lnls-elp/WEG/20150205_BOM_PCB_EXP_RS485.xls

Sheet: BOM_COMP_EXP_RS485
Item | Comment | Description | Designator | Manufacturer | Manufacturer Part Number | Quantity | Unit Price | Final Price | Intern Part Number | Purchased
1 | 10uF | CAP CER 10UF 35V 10% X5R 0805 | C1, C3 | TDK Corporation | C2012X5R1V106K085AC | 2 | 0,7 | 1.4 | AP105062 | OK
2 | 100nF | CAP CER 0.1UF 50V 10% X7R 0603 | C2, C4 | Samsung | CL10B104KB8SFNC | 2 | 0,1 | 0.2 | AP105057 | OK
3 | 133719 | Conector RJ11 SMD, Shielded, EMI Finger | CON1, CON3 | ERNI | 133719 | 2 | 0.77 | 1.54 | AP106016 | OK
4 | DW-04-10-F-S-590 | BOARD SPACING MICRO STRIPS. | CON2 | SAMTEC | DW-04-10-F-S-590 | 1 | 0.143 | 0.143 | AP107722 | OK
5 | FTSH-105-04-L-DV-A | 0.050 INCH DOUBLE VERTICAL SMT TERMINAL STIP. | CON4 | SAMTEC | FTSH-105-04-L-DV-A | 1 | 0.881 | 0.881 | AP107721 | OK
6 | MMBZ6V2ALT1G | TVS DIODE 3VWM 8.7VC SOT23 | D1 | ON Semiconductor | MMBZ6V2ALT1G | 1 | 0,25 | 0.25 | AP105033 | OK
7 | SM712 | Asymmetrical TVS Diode for Extended Common-Mode RS-485 | D2 | SEMTECH | SM712 | 1 | 1,46 | 1.46 | AP100468 | OK
8 | SMAJ11CA | Transient Voltage Suppressor Diode (Bi-Directional) 11V 400W BIDIR 5% SMA | D3 | Littel Fuse | SMAJ11CA | 1 | 0,47 | 0.47 | AP105034 | OK
9 | 220R/100Mhz | FERRITE BEAD,SMD 0805,220 OHMS | L1, L2 | Murata Electronics | BLM21PG221SN1D | 2 | 0,11 | 0.22 | AP105046 | OK
10 | SML-LXR44GC-TR | LED GREEN CLR LENS RA SMD 565NM | LD1 | Lumex Opto/Components Inc | SML-LXR44GC-TR | 1 | 0,58 | 0.58 | AP107062
11 | BC846B,215 | NXP Semiconductors | Q1 | NXP Semiconductors | BC846B | 1 | 0,14 | 0.14 | AP105095 | OK
12 | 499R | RES 499 OHM 1/10W 1% 0603 SMD | R1, R5 | Panasonic | ERJ-3EKF4990V | 2 | 0,1 | 0.2 | AP105081 | OK
13 | 10K | RES 10K OHM 1/16W 5% 0402 SMD | R2, R6 | Yageo | RC0402JR-0710KL | 2 | 0,1 | 0.2 | AP105072 | OK
14 | MMF25SFRE4R75 | RES SMD 4.75 OHM 1% 1/4W MELF | R3, R4 | Yageo | MMF25SFRE4R75 | 2 | 0,28 | 0.56 | AP105089 | OK
15 | HCPL-181-000E | OPTOISO 3.75KV TRANSISTOR 4SOIC | U1 | Avago Technologies US Inc. | HCPL-181-000E | 1 | 0,67 | 0.67 | AP105013 | OK
16 | IL3685E | PROFIBUS RS-485 INTERFACE ISO | U2 | NVE Corp/Isolation Products | IL3685E | 1 | 7,2 | 7.2 | AP102999 | OK
 |  |  |  |  |  | Total Cost ($): |  | 16.114
 |  |  |  |  | Cotação do dolar (R$) | 2.54
 |  |  |  |  |  | Total Cost (R$): |  | 40.92956

Sheet: BOM_MEC_EXP_RS485
Item | Description | Manufacturer | Manufacturer Part Number | Supplier | Quantity | Unit Price | Final Price | Intern Part Number | Purchased
1 | Espaçador sextavado 15mm rosca M3 fêmea/fêmea Bronze | Harwin Inc | R30-1001502 |  | 2 | 1.5 | 3 | AP107696
2 | Espaçador sextavado 7mm rosca M3 macho/fêmea Bronze | Harwin Inc | R30-3000702 |  | 2 | 1.8 | 3.6 | AP107697
3 | Parafuso máquina cabeça panela philips aço niquelado M3X6mm | Aguiafix |  | Aguiafix | 4 | 0.0246 | 0.0984 | AO105170 | OK
 |  |  |  |  | Total Cost (R$): |  | 6.6984
