lnls-elp/WEG/20150205_BOM_PCB_UDC_IHM_V2.0.xls

Item | Comment | Description | Designator | Manufacturer | Manufacturer Part Number | Quantity
1 | 100nF | CAP CER 0.1UF 50V 10% X7R 0603 | C1, C4, C6, C8, C18 | Samsung Electro-Mechanics America, Inc | CL10B104KB8SFNC | 5
2 | 10uF | CAP,CER,SMD 0603,10uF,16V,X5R,+/-20% | C2, C3, C7, C10, C19, C20, C34 | TDK Corporation | C1608X5R1C106M080AB | 7
3 | 10nF | CAP CER 10000PF 16V 10% X7R 0402 | C5, C12, C13, C14, C15, C16, C17 | Samsung | CL05B103KO5NNNC | 7
4 | 100nF | CAP CER 0.1UF 10V 10% X5R 0402 | C9, C11, C21, C22, C23, C24, C25, C26, C27, C32, C33, C35, C36 | Kemet | C0402C104K8PACTU | 13
5 | 22pF | CAP CER 22PF 50V 5% NP0 0402 | C28, C29, C30, C31 | Kemet | C0402C220J5GACTU | 4
6 | CLP-105-02-L-D-A-K-TR | CONN RCPT 10POS DUAL .05" SMD | CON1 | Samtec | CLP-105-02-L-D-A-K-TR | 1
7 | TSM-103-01-S-DV-A-M-TR | Terminal Strip, Dual Row Vertical, Surface Mount, 0.100" Pitch, 6 Pins. | CON2 | SAMTEC | TSM-103-01-S-DV-A-M-TR | 1
8 | MUSB-05-S-B-SM-A-K-TR | USB 2.0, Right Angle, SMT, B Type, Receptacle, 5 Position | CON3 | Samtec | MUSB-05-S-B-SM-A-K-TR | 1
9 | ES2A | Diode | D1 | FAIRCHILD SEMICONDUCTOR | ES2A | 1
10 | MMSD4148 | DIODE SML SIG 100V 0.2A SOD123 | D2 | Fairchild Semiconductor | MMSD4148 | 1
11 | MI0283QT-9A | Display TFT 320x240 com tela resistiva | DISP1 | Multi-inno | MI0283QT-9A | 1
12 | 220R/100Mhz | FERRITE CHIP 220 OHM 0805 | L1, L2, L3 | Murata Electronics | BLM21PG221SN1D | 3
13 | AA3528CGSK | LED GREEN ROUND CLEAR SMD 100mcd, PLLC 2 | LD1 | Kingbright | AA3528CGSK | 1
14 | HSMC-A100-Q00J1 | LED 635NM RED 2-PLCC SMD | LD2 | Avago Technologies US Inc. | HSMC-A100-Q00J1 | 1
15 | LTST-C170KRKT | LED SUPER RED CLEAR 0805 SMD | LD3, LD4 | Lite-On Inc | LTST-C170KRKT | 2
16 | BC846B | TRANS NPN 65V 0.1A SOT23 | Q1, Q2, Q3 | NXP Semiconductors | BC846B,215 | 3
17 | 49.9R | RES 49.9 OHM 1/10W 1% 0402 SMD | R1, R2 | Panasonic Electronic Components | ERJ-2RKF49R9X | 2
18 | 100R | RES 100 OHM 1/8W 1% SMD 0603 | R3, R14 | Vishay Beyschlag | MCT06030C1000FP500 | 2
19 | 100K | RES 100K OHM 1/10W 5% 0603 SMD | R4 | Yageo | RC0603JR-07100KL | 1
20 | 10K | RES 10K OHM 1/16W 5% 0402 SMD | R5, R6, R8, R10, R13, R17, R21, R22 | Yageo | RC0402JR-0710KL | 8
21 | 1K | RES 1.00K OHM 1/8W 1% SMD 0603 | R7 | Vishay Beyschlag | MCT06030C1001FP500 | 1
22 | 12R | RES 12 OHM 1/2W 5% 0805 SMD | R9 | Panasonic Electronic Components | ERJ-P06J120V | 1
23 | 300K | RES 300K OHM 1/10W 1% 0603 SMD | R11, R12 | Panasonic Electronic Components | ERJ-3EKF3003V | 2
24 | 270R | RES 270 OHM 1/10W 1% 0603 SMD | R15, R16 | Vishay Dale | CRCW0603270RFKEA | 2
25 | 499R | RES 499 OHM 1/10W 1% 0603 SMD | R18, R19 | Panasonic | ERJ-3EKF4990V | 2
26 | 33R | RESISTOR, THICK FILM, 33 OHM, 100mW, 1% | R20 | VISHAY DALE | CRCW060333R0FKEA | 1
27 | CSS-73B16K-SMT | BUZZER MAGNETIC 3.6V 8.5MM SMD | SPK1 | CUI Inc | CSS-73B16K-SMT | 1
28 | PTS810 SJM | SWITCH TACTILE SPST-NO 0.05A 16V | SW1 | C&K Components | PTS810 SJM 250 SMTR LFS | 1
29 | NTA7002NT1G | MOSFET N-CH 30V 154MA SOT-416 | T1 | ON Semiconductor | NTA7002NT1G | 1
30 | TPS79533DC | IC REG LDO 3.3V 0.5A SOT223-6 | U1 | Texas Instruments | TPS79533DCQR | 1
31 | USBLC6-2SC6 | STMICROELECTRONICS - USBLC6-2SC6 - ESD PROTECTION, 3.5PF, 17V, SOT23 | U2 | STMICROELECTRONICS | USBLC6-2SC6 | 1
32 | AT24C64D-SSHM-T | IC EEPROM 64KBIT 1MHZ 8SOIC | U3 | Atmel | AT24C64D-SSHM-T | 1
33 | PIC32MX795F512L-80I/PT | High Performance 80 MHz MIPS-Based 32-Bit Flash Microcontroller with USB, CAN and Ethernet, 512KB Program Memory, 100-pin TQFP, V-Temperature, Tape and Reel | U4 | Microchip | PIC32MX795F512L-80I/PT | 1
34 | SN74LVC1G08DBVR | IC GATE AND 1CH 2-INP SOT-23-5 | U5, U7 | Texas Instruments | SN74LVC1G08DBVR | 2
35 | SN74LVC2G06DBVR | IC INVERTER DUAL 1INPUT SOT23-6 | U6 | Texas Instruments | SN74LVC2G06DBVR | 1
36 | SN74LVC1G3157-Q1 | Analog Switch ICs Auto Cat Sngl-Pole Dbl-Thrw Anlg Switch | U8 | Texas Instruments | 1P1G3157QDBVRQ1 | 1
37 | ABS07-32.768KHZ-T | ABRACON - ABS07-32.768KHZ-T - CRYSTAL, 32.768KHZ, 12.5PF, SMD | X1 | ABRACON | ABS07-32.768KHZ-T | 1
38 | ABM3B-8.000MHZ-10-1-U-T | CRYSTAL 8MHZ 10PF SMD | X2 | Abracon Corporation | ABM3B-8.000MHZ-10-1-U-T | 1
