lnls-elp/WEG/20150601_BOM_UDC_PLACA_DE_CONTROLE_V2.0.xlsx

Item | Comment | Description | Designator | Manufacturer | Manufacturer Part Number | Quantity per Board | Intern Part Number | Assembly
1 | BU2032SM-HD-G | HOLDER COIN CELL 2032 SMD | BT1 | MPD (Memory Protection Devices) | BU2032SM-HD-G | 1 | AP107957
2 | 100nF | CAP CER 0.1UF 10V 10% X5R 0402 | C1, C2, C3, C4, C8, C9, C10, C12, C15, C16, C17, C18, C23, C24, C29, C30, C35, C36, C41, C42, C45, C46, C47, C48, C49, C50, C51, C52, C53, C54, C57, C62, C64, C68, C70, C73, C75, C104, C105, C108, C109, C111, C115, C141, C142, C145, C148, C149, C152, C153, C155, C156, C158, C159, C161, C162, C163, C167, C169, C170, C172, C173, C174, C175, C176, C177, C179, C180, C183, C184, C186, C190, C191 | Kemet | C0402C104K8PACTU | 73 | AP105056
3 | 10pF | CAP CER 10PF 50V 5% NP0 0402 | C5, C6 | Samsung Electro-Mechanics America, Inc | CL05C100JB51PNC | 2 | AP107449
4 | 10uF | CAP CER 10UF 16V 20% X5R 0603 | C7, C43, C44, C55, C56, C74, C76, C146, C164, C178, C181, C182, C185,C188, C189 | TDK Corporation | C1608X5R1C106M080AB | 15 | AP105460
5 | 1uF | CAP CER 1UF 16V 10% X7R 0603 | C11, C14, C69, C143, C144, C147, C150, C151, C154, C157, C160, C168, C171, C187, C192 | TDK Corporation | C1608X7R1C105K080AC | 15 | AP105441
6 | 10nF | CAP CER 10000PF 16V 10% X7R 0402 | C13 | Samsung Electro-Mechanics America, Inc | CL05B103KO5NNNC | 1 | AP105053
7 | 100nF | CAP CER 0.1UF 50V 10% X7R 0603 | C19, C20, C21, C22, C25, C26, C27, C28, C31, C32, C33, C34, C37, C38, C39, C40, C65, C66, C72, C112, C114, C122, C123, C128, C129, C166 | Samsung | CL10B104KB8SFNC | 26 | AP105057
8 | 100uF/35V | CAP ALUM 100UF 35V 20% SMD | C58, C59 | Panasonic | EEE-HAV101XAP | 2 | AP105066
9 | 10uF | CAP CER 10UF 35V 10% X5R 0805 | C60, C71, C110, C113, C165 | TDK Corporation | C2012X5R1V106K085AC | 5 | AP105062
10 | 22uF | CAP CER 22UF 16V 20% X5R 1206 | C61 | Murata Electronics | GRM31CR61C226ME15L | 1 | AP105065
11 | 3.3nF | CAP CER 3300PF 25V 10% X7R 0402 | C63 | Kemet | C0402C332K3RACTU | 1 | AP105063
12 | 10nF | CAP CER 10000PF 1.5KV X7R 1812 | C67, C117 | AVX Corporation | 1812SC103KAT1A | 2 | AP107450
13 | 2.2uF | CAP CER 2.2UF 10V 10% X7R 0603 | C77, C78, C79, C88, C89, C90, C91, C92, C93, C94, C95, C96, C97, C98, C99, C100, C101, C102, C103 | Murata Electronics | GRM188R71A225KE15D | 19 | AP105054
14 | 470nF | CAP CER 0.47UF 6.3V 10% X5R 0402 | C80, C81, C82, C83, C84, C85, C86, C87 | Murata Electronics | GRM155R60J474KE19D | 8 | AP105055
15 | 15pF | CAP CER 15PF 50V 5% NP0 0402 | C106, C107 | Murata Electronics | GRM1555C1H150JA01D | 2 | AP105059
16 | 1nF | CAP CER 1000PF 50V 10% X7R 0603 | C116 | Murata | GRM188R71H102KA01D | 1 | AP107451
17 | 1.2nF | CAP CER 1200PF 25V 5% NP0 0603 | C118, C119, C124, C125, C130, C131, C134, C135 | Murata Electronics North America | GRM1885C1E122JA01D | 8 | AP105068
18 | 180nF | CAP CER 0.18UF 25V 10% X7R 0603 | C120, C121, C126, C127, C132, C133, C136, C137 | Murata Electronics North America | GRM188R71E184KA88D | 8 | AP105067
19 | 1uF | CAP CER 1UF 50V 20% X5R 0603 | C138, C139, C140 | TDK Corporation | C1608X5R1H105M080AB | 3 | AP105061
20 | LPJ19201BGNL | Conector RJ45 Ethernet, com trafo, SMD, LINK-PP | CON1 | LINK-PP Int'l Technology Co.,Limited | LPJ19201BGNL | 1 | AP105406
21 | 101-00581-59 | CONN MICRO SD CARD PUSH-PUSH R/A | CON2 | Amphenol Commercial Products | 101-00581-59 | 1 | AP105409
22 | CLP-107-02-L-D-A-K-TR | CONN RCPT 14POS DUAL .05" SMD | CON3 | Samtec | CLP-107-02-L-D-A-K-TR | 1 | AP107723
23 | MUSB-05-S-B-SM-A-K-TR | SAMTEC - MUSB-05-S-B-SM-A-K-TR - CONNECTOR, MINI USB B, RECEPTACLE, SMT | CON4 | Samtec | MUSB-05-S-B-SM-A-K-TR | 1 | AP107443
24 | 374047 |  | CON5 | ERNI | 374047 | 1 | AP102124
25 | 354144 |  | CON6 | ERNI | 354144 | 1 | AP102125
26 | BCS-103-L-D-HE | CONN RCPT 6POS .100" DUAL HORZ | CON7 | Samtec Inc | BCS-103-L-D-HE | 1 | AP107454
27 | CLP-105-02-L-D-A-K-TR | CONN RCPT 10POS DUAL .05" SMD | CON8, CON10 | Samtec | CLP-105-02-L-D-A-K-TR | 2 | AP107441
28 | Header 2 | Header, 2-Pin | CON9, CON11, TP1 |  |  | 3
29 | BAW156 | DIODE ARRAY 85V 140MA SOT23 | D1, D2, D3, D4, D5, D6, D7, D8 | Diodes Incorporated | BAW156-7-F | 8 | AP105032
30 | ES2A | DIODE GEN PURP 50V 2A DO214AA | D9 | FAIRCHILD SEMICONDUCTOR | ES2A | 1 | AP107737
31 | SMAJ16A | TVS DIODE 16VWM SMD | D10 | Littel Fuse | SMAJ16A | 1 | AP105035
32 | BZX84C3V3 | Diode Zener Anode Pin 1 Cathode Pin 3 (Pas de pin 2) | D11, D12 | FAIRCHILD SEMICONDUCTOR | BZX84C3V3 | 2 | AP107738
33 | UPTB10E3/TR13 | TVS DIODE 10VWM 18VC POWRMITE1 | D13, D14, D15, D16, D17, D18, D19, D20 | Microsemi Commercial Components Group | UPTB10E3/TR13 | 8 | AP107455
34 | 220R/100Mhz | FERRITE CHIP 220 OHM 0805 | L1, L5, L6, L7, L8, L9, L10, L23, L24, L26, L27, L28, L29, L30, L31, L32, L33, L34, L35, L36, L37, L38, L39, L40, L41, L42, L43, L48, L49, L50, L51, L52, L53, L54 | Murata Electronics | BLM21PG221SN1D | 34 | AP105046
35 | VLCF4020T-2R2N1R7 | FIXED IND 2.2UH 1.72A 59 MOHM | L2 | TDK Corporation | VLCF4020T-2R2N1R7 | 1 | AP105042
36 | XFL4020-332MEC | Fixed Inductors Power Inductor 3.3 uH 20 % 5.2 A | L3 | Coilcraft | XFL4020-332MEC | 1 | AP105041
37 | 60R/100Mhz | FERRITE CHIP 60 OHM 6000MA 1806 | L4 | Murata Electronics | BLM41PG600SN1L | 1 | AP105045
38 | 60R/100Mhz | FERRITE BEAD 60 OHM 0805 | L11, L12, L13, L14, L15, L16, L17, L18, L19, L20, L21, L22 | Taiyo Yuden | BKP2125HS600-T | 12 | AP105044
39 | DLP11SN900HL2L | CHOKE COIL COMMON MODE 150MA SMD | L25 | Murata Electronics North America | DLP11SN900HL2L | 1 | AP105043
40 | 1000R/100Mhz | FERRITE CHIP 1000 OHM 400MA 0603 | L44, L45, L46, L47 | Murata Electronics | BLM18AG102SN1D | 4 | AP105047
41 | LTST-C170KRKT | LED SUPER RED CLEAR 0805 SMD | LD1, LD2, LD3, LD4, LD5, LD6 | Lite-On Inc | LTST-C170KRKT | 6 | AP105093
42 | MMUN2111LT1G | TRANS PREBIAS PNP 246MW SOT23-3 | Q1 | On Semiconductor | MMUN2111LT1G | 1 | AP105027
43 | MMUN2232LT1G | TRANS PREBIAS NPN 246MW SOT23-3 | Q2 | On Semiconductor | MMUN2232LT1G | 1 | AP105026
44 | NTA7002NT1G | MOSFET N-CH 30V 154MA SOT-416 | Q3, Q4, Q5 | ON Semiconductor | NTA7002NT1G | 3 | AP105437
45 | 49.9R | RES 49.9 OHM 1/10W .1% 0603 SMD | R1, R2, R3, R4, R88, R89, R96, R97, R104, R105, R112, R113, R147, R148, R169, R170, R171, R172, R173, R174, R175, R176 | Panasonic Electronic Components | ERA-3AEB49R9V | 22 | AP105077
46 | 33R | RES 33 OHM 1/16W 5% 0402 SMD | R5, R6, R7, R8, R9, R10, R11, R12, R13, R14, R15, R17, R18, R19, R20, R21, R22 | Yageo | RC0402JR-0733RL | 17 | AP105444
47 | 2.2K | RES SMD 2.2K OHM 5% 1/10W 0603 | R16, R30, R31, R32, R33, R34 | Bourns Inc. | CR0603-JW-222GLF | 6 | AP105446
48 | 2.21K | RES 2.21K OHM 1/10W 1% 0402 SMD | R23, R24, R25, R26, R29, R77, R82, R83 | Panasonic Electronic Components | ERJ-2RKF2211X | 8 | AP105069
49 | 330R | RES 330 OHM 1/16W 5% 0402 SMD | R27, R28, R38 | Yageo | RC0402JR-07330RL | 3 | AP105445
50 | 4.87K | RES 4.87K OHM 1/10W 1% 0603 SMD | R35 | Panasonic Electronic Components | ERJ-3EKF4871V | 1 | AP105447
51 | 10K | RES 10K OHM 1/16W 5% 0402 SMD | R36, R37, R60, R61, R62, R63, R64, R66, R73, R75, R121, R138, R139, R141, R178, R179, R180 | Yageo | RC0402JR-0710KL | 17 | AP105072
52 | 330R | RES 330 OHM 1/10W 5% 0603 SMD | R39, R40, R41, R42, R43, R44, R45, R46, R47, R48, R49, R50, R51, R52, R53, R54 | Panasonic Electronic Components | ERJ-3GEYJ331V | 16 | AP105082
53 | 49.9R | RES 49.9 OHM 1/10W 1% 0402 SMD | R57, R58, R59, R65, R149, R150, R151, R152, R153, R154, R155, R156 | Panasonic Electronic Components | ERJ-2RKF49R9X | 12 | AP105075
54 | 4.99K | RES 4.99K OHM 1/10W 1% 0402 SMD | R67, R84, R85, R157, R158, R159, R160 | Panasonic | ERJ-2RKF4991X | 7 | AP105071
55 | 100K | RES,SMD 0603,100K OHM,5%,1/10 WATT | R68, R94, R95, R102, R103, R110, R111, R118, R119 | Yageo | RC0603JR-07100KL | 9 | AP105076
56 | 10K | RES 10K OHM 1/10W 1% 0603 SMD | R69, R70, R71 | Panasonic Electronic Components | ERJ-3EKF1002V | 3 | AP106688
57 | 2K | RES 2.00K OHM 1/8W 1% SMD 0603 | R72 | Vishay | MCT06030C2001FP500 | 1 | AP105088
58 | 499R | RES 499 OHM 1/10W 1% 0603 SMD | R74, R142, R143, R144, R145, R146, R177 | Panasonic | ERJ-3EKF4990V | 7 | AP105081
59 | 1K | RES 1.00K OHM 1/8W 1% SMD 0603 | R76 | Vishay | MCT06030C1001FP500 | 1 | AP105080
60 | 57.6K | RES SMD 57.6K OHM 1% 1/10W 0402 | R78, R79, R80, R81 | Panasonic Electronic Components | ERJ-2RKF5762X | 4 | AP105070
61 | 24R | RES 24 OHM 1/10W 1% 0603 SMD | R86, R87 | Panasonic Electronic Components | ERJ-3EKF24R0V | 2 | AP107457
62 | 20R | RES SMD 20 OHM 1% 1/10W 0603 | R90, R91, R98, R99, R106, R107, R114, R115 | Panasonic Electronic Components | ERJ-3EKF20R0V | 8 | AP105078
63 | 180R | RES 180 OHM 1/10W 1% 0603 SMD | R92, R93, R100, R101, R108, R109, R116, R117 | Panasonic Electronic Components | ERJ-3EKF1800V | 8 | AP105079
64 | 110R | RES 110 OHM 1/8W 5% 0805 SMD | R122, R123, R124, R125, R126, R127, R128, R129, R130, R131, R132, R133, R134, R135, R136, R137 | Panasonic Electronic Components | ERJ-6GEYJ111V | 16 | AP107458
65 | 680R | RES 680 OHM 1/10W 5% 0603 SMD | R161, R162, R165, R166 | Panasonic Electronic Components | ERJ-3GEYJ681V | 4 | AP107459
66 | 160R | RES 160 OHM 1/2W 5% 0805 SMD | R163, R164, R167, R168 | Panasonic Electronic Components | ERJ-P06J161V | 4 | AP105086
67 | 7914S-1-000E | SWITCH TACTILE SPST-NO 0.1A 24V | SW1 | Bourns | 7914S-1-000E | 1 | AP105040
68 | TLK110PT | Industrial Temp, Single Port 10/100 Mb/s Ethernet Physical Layer Transceiver, -40 to 85 degC, 48-Pin LQFP (PT), Green (RoHS & no Sb/Br) | U1 | Texas Instruments | TLK110PT | 1 | AP105404
69 | F28M36P63C2ZWTT | ARM Microcontrollers - MCU Concerto Microcntrlr | U2 | Texas Instruments | F28M36P63C2ZWTT | 1 | AP105105
70 | TLP2160(F) | ISOLATOR 2.5KVRMS 2CH TOTEM 8SO | U3, U4, U5, U6, U7, U8, U9, U10 | Toshiba Semiconductor and Storage | TLP2160(F) | 8 | AP105011
71 | SN74LVC540APWR | IC INVERTER 8-INPUT 20TSSOP | U11, U12 | Texas Instruments | SN74LVC540APWR | 2 | AP107462
72 | MT48LC32M16A2P-75 IT:C | IC SDRAM 512MBIT 133MHZ 54TSOP | U13 | Alliance Memory, Inc. | MT48LC32M16A2P-75 IT:C | 1 | AP107739
73 | W25Q128FVSIG | IC FLASH 128MBIT 104MHZ 8SOIC | U14 | Winbond Electronics | W25Q128FVSIG | 1 | AP105434
74 | AT24C64D-SSHM-T | IC EEPROM 64KBIT 1MHZ 8SOIC | U15 | Atmel | AT24C64D-SSHM-T | 1 | AP107460
75 | TPS62291DRVT | Buck Step Down Regulator with 2.3 to 6 V Input and 3.3 V Output, -40 to 85 degC, 6-Pin SON (DRV), Green (RoHS & no Sb/Br) | U16 | Texas Instruments | TPS62291DRVT | 1 | AP105005
76 | TPS62143RGTR | Buck Step Down Regulator with 3 to 17 V Input and 5 V Output, -40 to 85 degC, 16-Pin QFN (RGT), Green (RoHS & no Sb/Br) | U17 | Texas Instruments | TPS62143RG | 1 | AP105006
77 | LP3470M5-3.08 | Tiny Power On Reset Circuit, 5-pin SOT-23 | U18 | National Semiconductor | LP3470M5-3.08/NOPB | 1 | AP105019
78 | R-78E5.0-0.5 | CONV DC/DC 5V 500MA OUT THRU | U19 | Recom Power | R-78E5.0-0.5 | 1 | AP105018
79 | RS-0515D/H3 | CONV DC/DC 2W 4.5-9VIN +/-15V | U20 | Recom Power | RS-0515D/H3 | 1 | AP105017
80 | HCPL-181-000E | OPTOISO 3.75KV TRANSISTOR 4SOIC | U21, U51 | Avago Technologies US Inc. | HCPL-181-000E | 2 | AP105013
81 | MCP9701T-E/TT | Low-Power Linear Active Thermistor IC, 3-Pin SOT-23, Extended Temperature, Tape and Reel | U22 | Microchip Technology | MCP9701T-E/TT | 1 | AR101905
82 | ADUM1100ARZ-RL7 | DGTL ISO 2.5KV GEN PURP 8SOIC | U23 | Analog Devices | ADUM1100ARZ | 1 | AP107461
83 | ADUM4160BRWZ-RL | DGTL ISOLATOR 5KV 2CH USB 16SOIC | U24 | Analog Devices Inc | ADUM4160BRWZ-RL | 1 | AP107061
84 | USBLC6-2SC6 | TVS DIODE 5.25VWM 17VC SOT23-6 | U25 | STMicroelectronics | USBLC6-2SC6 | 1 | AP100435
85 | OPA4140AID | 11 MHz, Single Supply, Low Noise, Precision, Rail-to-Rail Output, JFET Amplifier, 4.5 to 36 V, -40 to 125 degC, 14-pin SOIC (D14), Green (RoHS & no Sb/Br) | U26, U27 | Texas Instruments | OPA4140AID | 2 | AP105014
86 | ADS8638SRGER | IC ADC 12B SPI 1MSPS 8CH 24VQFN | U28 | Texas Instruments | ADS8638SRGER | 1 | AP105015
87 | TXB0108PWR | IC 8-BIT TRNSTR 15KV ESD 20TSSOP | U29, U31, U34, U44 | Texas Instruments | TXB0108PWR | 4 | AP104567
88 | PCA9538BS,118 | IC I/O EXPANDER I2C 8B 16HVQFN | U30 | NXP Semiconductors | PCA9538BS,118 | 1 | AP105022
89 | SN74LVC1G08DBVR | IC GATE AND 1CH 2-INP SOT-23-5 | U32, U33, U35 | Texas Instruments | SN74LVC1G08DBVR | 3 | AP104997
90 | IDT74FCT162244ET | IC BUFF DVR 16BIT N-INV 48TSSOP | U36 | IDT, Integrated Device Technology Inc | IDT74FCT162244ETPAG | 1 | AP105010
91 | TPS2051BDBVR | IC PWR DIST SWITCH SNGL SOT23-5 | U37 | Texas Instruments | TPS2051BDBVR | 1 | AP105524
92 | SN74LVC2G06DBVR | IC INVERTER DUAL 1INPUT SOT23-6 | U38, U43, U46 | Texas Instruments | SN74LVC2G06DBVR | 3 | AP107447
93 | Si8662BC-B-IS1R | DGTL ISO 3.75KV GEN PURP 16SOIC | U39 | Silicon Labs | SI8662BC-B-IS1 | 1 | AP105458
94 | ISO1540DR | IC DGTL ISO 4CH I2C 8SOIC | U40 | Texas Instruments | ISO1540DR | 1 | AP104989
95 | TPD4E002DRLR | TVS DIODE 3VWM SOT5 | U41 | Texas Instruments | TPD4E002DRL2 | 1 | AP105004
96 | HCPL-2231-300E | OPTOCPLR LOG-OUT 2CH 5MBD GW SMD | U42, U45 | Avago Technologies US Inc. | HCPL-2231-300E | 2 | AP107463
97 | ADUM1400CRWZ | DGTL ISO 2.5KV GEN PURP 16SOIC | U47, U49 | Analog Device | ADUM1400CRWZ | 2 | AP105008
98 | M41T83ZMY6F | IC RTC CLK/CALENDAR I2C 18-SOX | U52 | STMicroelectronics | M41T83ZMY6F | 1 | AP107741
99 | 25MHZ, 50ppm | CRYSTAL 25MHZ 8PF SMD | X1 | NDK | NX5032GA-25.000000MHZ-LN-CD-1 | 1 | AN100050
100 | ABM3B-20.000MHZ-10-1-U-T | CRYSTAL 20MHZ 10PF SMD | X2 | Abracon Corporation | ABM3B-20.000MHZ-10-1-U-T | 1 | AN100051
101 | CR2032 | BATTERY LITHIUM COIN 3V 20MM |  | Panasonic - BSG | CR2032 | 1 | AP102303
