lnls-elp/WEG/Backplane - BOM List.xls

PartNumber | Manufacturer | Comment | Description | Designator | Footprint | LibRef | Quantity
1755794 | Phoenix | Family | Connector 8 Male | CON1, CON4 | PHOENIX_1755794 | PHOENIX_1755794 | 2
225688 | ERNI | 225688 | Terminals 12P M4 PRESSFIT VERT HP FML THRD | CON2, CON3, CON5, CON6 | 225688 | 225688 | 4
 | Amphenol | BNC | BNC Elbow Connector | CON7 | 919-109J-51PX | BNC | 1
054546 | ERNI | 054546 | ERNI Electronics 55P 2MM Pressfit VERT MALE BCKPLN | CON8, CON9, CON10 | ERNI_054546 | ERNI_054546 | 3
54392 | ERNI | ERNI 054392 |  | CON11 | ERNI_054392 | ERNI_054392 | 1
FCI_D09S24A4GV00LF | Amphenol | D-Sub 9F | Connector D-sub 9 Female | DB1 | FCI_D09S24A4GV00LF | FCI_D09S24A4GV00LF | 1
09 05 248 6851 | Harting | 09062487832 | Eurocard DIN 41612, Type E, 48 Postion, Rows a+c+e, Performance level 2, Female, Lead 11.5 mm, Pitch 5.08 mm | P1 | 0905248x851 | 09 05 248 6851 | 1
 |  | Header 10H | Header, 10-Pin, Right Angle | P2 | HDR1X10H | Header 10H | 1
 |  | Header 2 | Header, 2-Pin | P3, P4 | HDR1X2 | Header 2 | 2
EMCV 1,5/4-GF-3.81 | Phoenix | EMCV 1,5/4-GF-3.81 | Header, 4-Pin | P5, P6 | EMCV 1,5/4-GF-3.81 | Header 4 | 2
