lnls-elp/WEG/BOM_Mecanica_Exp_RS485_V1.0_20150130_Custo.xlsx

BOM list Mecânica Placa de Expansão RS-485
Item | Qtd | Descrição | Part Number | Fabricante | Preço unitário (R$) | Preço total (R$) | N Cadastro SC
1 | 2 | Espaçador sextavado 15mm rosca M3 fêmea/fêmea Bronze | R30-1001502 | Harwin Inc | 1.50 | 3
2 | 2 | Espaçador sextavado 7mm rosca M3 macho/fêmea Bronze | R30-3000702 | Harwin Inc | 1.8 | 3.6
3 | 4 | Parafuso máquina cabeça panela philips aço niquelado M3X6mm |  |  |  | 0
 |  |  |  |  | Custo total (R$): | 6.6
