lnls-elp/WEG/DCCT_BOARD_V1.0 - BOM List.xls

Part Number | Manufacturer | Comment | Description | Designator | Footprint | LibRef | Quantity
 |  | 100nF | Capacitor | C1, C3 | 0805 cap | Cap Ceram 0805 | 2
 |  | 10uF | Capacitor | C2, C4 | 0805 cap | Cap Ceram 0805 | 2
1786006 | Phoenix | 1786006 | TERM BLOCK HDR 8POS VERT 5.08MM | CON1, CON2 | 1786006 | 1786006 | 2
SMBJ15A | LittelFuse | SMBJ15A | Zener Diode | D1, D2 | DIOM5336X265N | SMBJ15A | 2
ITN 12-P | LEM | ITN 12-P | High Performance Current Transducer for PCB assembly | DCCT1 | ITN 12-P | ITN 12-P | 1
BLM21PG221SN1D | Murata Electronics | 220R/100Mhz | FERRITE BEAD,SMD 0805,220 OHMS | L1, L2 | 0805 ferrit | Ferrite Bead 0805 | 2
 |  | 0R0 | Resistor 1/4W | R1 | 0805 res | Resistor 0805 | 1
