lnls-elp/WEG/HRADC_Board_v2_0 - BOM List (WEG).xls

Designator | Description | Value | PartNumber | PackageReference | Manufacturer | Quantity
C100, C102, C105, C106, C512, C513, C514, C515 | Tantalum Capacitor 10uF 16V 10% SMD R | 10uF | TPCR106K016R1800 | R | AVX Corporation | 8
C101, C103, C104, C107, C109, C111, C113, C202, C204, C206, C207, C208, C209, C210, C212, C214, C216, C221, C223, C227, C229, C235, C236, C237, C238, C239, C242, C243, C300, C301, C302, C303, C304, C307, C308, C311, C400, C500, C501, C502, C503, C504, C505, C506, C507, C508, C509, C510, C511, C516, C519, C603, C604, C605, C607, C609, C612, C614, C617, C619, C622, C626, C630, C631, C636, C639, C644, C645 | Ceramic Capacitor 100nF 50V 10% SMD 0603 X7R | 100nF | C1608X7R1H104K080AA | 0603 | TDK Corporation | 68
C108, C110, C203, C205, C211, C213, C215, C217, C222, C224 | Tantalum Capacitor 10uF 25V 10% SMD B Low ESR | 10uF | TR3B106K025C0450 | B (J) | Vishay Sprague | 10
C112 | Tantalum Capacitor 47uF 6.3V 20% SMD B Low ESR | 47uF | T520B476M006ATE025 | B (J) | Kemet | 1
C200 | Ceramic X2Y Capacitor 1uF 16V 20% SMD 1210 | 1uF | 160X41W105MV4E | 1210_X2Y | Johanson Dielectrics Inc | 1
C201 | Ceramic Chip Capacitor SMD 0805 |  |  | 0805 |  | 1
C218, C219, C225, C226 | Ceramic Capacitor 3.3nF 50V 1% SMD 0805 NP0 | 3.3nF | GRM2165C1H332FA01J | 0805 | Murata Electronics | 4
C228 | Ceramic Capacitor 2.7nF 50V 2% SMD 0603 NP0 | 2.7nF | GRM1885C1H272GA01D | 0603 | Murata Electronics North America | 1
C230, C232 | Tantalum Capacitor 2.2uF 35V 20% SMD B Low ESR | 2.2uF | TCJB225M035R0200 | B (J) | AVX Corporation | 2
C231, C233, C608, C613, C618, C625, C629, C632, C635, C640, C643 | Ceramic Capacitor 1uF 25V 10% SMD 0805 X5R | 1uF | C2012X5R1E105K085AC | 0805 | TDK Corporation | 11
C234, C611, C616, C621 | Ceramic Capacitor 10uF 50V 10% SMD 1206 JB | 10uF | C3216JB1H106K160AB | 0805 | TDK Corporation | 4
C240 | Ceramic Chip Capacitor SMD 1206 |  |  | 1206 |  | 1
C241 | Ceramic Chip Capacitor SMD 1210 |  |  | 1210 |  | 1
C305, C306, C309, C310, C517, C518 | Ceramic Capacitor 2.2uF 25V 10% SMD 0603 JB | 2.2uF | C1608JB1E225K080AB | 0603 | TDK Corporation | 6
C601, C623, C637 | Aluminum-Polymer Capacitor 100uF 25V 20% SMD D8 Low ESR | 100uF | EEH-ZA1E101XP | Radial_D8 | Panasonic Electronic Components | 3
C602 | Ceramic Capacitor 22uF 25V 10% SMD 1210 X5R | 22uF | GRM32ER61E226KE15L | 1210T | Murata Electronics North America | 1
C606 | Ceramic Capacitor 47uF 10V 20% SMD 1812 X5R | 47uF | C4532X5R1A476M280KA | 1812 | TDK Corporation | 1
C610, C615, C620, C624, C628, C634, C638, C642 | Tantalum Capacitor 22uF 25V 20% SMD C Low ESR | 22uF | TCJC226M025R0100 | C (J) | AVX Corporation | 8
C627, C633, C641 | Ceramic Capacitor 10nF 50V 5% SMD 0603 X7R | 10nF | C0603C103J5RACTU | 0603 | Kemet | 3
CON400, CON401 | ERNI Electronics 55P 2MM R/A FML SHLD DAUG CARD TYPE C |  | 374047 |  | ERNI Electronics | 2
CON402 | Connector Header 10-pin Male Shrouded; Pitch 2.54mm | 10-pin | SBH11-NBPC-D05-SM-BK | HEADER_5X2 | Sullins Connector Solutions | 1
CON403 | Connector Header 16-pin Male, Pitch 2.54mm |  |  |  |  | 1
CON404 | Connector Header 4-pin Male Pitch 2.54mm |  |  |  |  | 1
CON405 | BNC Jack Right Angle PCB |  | 0731375003 | BNC_JACK_FEMALE | Molex Inc. | 1
D200 |  |  |  | SOD_323 |  | 1
D600 | DUAL SURFACE MOUNT SCHOTTKY BARRIER DIODE |  | SDM40E20LS-7-F | SOT_23 | Diodes Inc. | 1
D601, D602, D603 | Transient Voltage Suppressor Diode (Uni-Directional) | 16V | SMAJ16A | DO214 | Bourns Inc. | 3
L100, L101 | Chip Ferrite Bead 1000Ohm/100MHz 100mA SMD 0603 |  | MZ1608-102Y | 0603 | Bourns Inc. | 2
L200 | SMD Common Mode Line Filter | 4.7mH | 744220 | 4-Pad SMD | Wurth Electronics Inc | 1
L600 | Semi-shielded Power Inductor | 3.3 uH | SRN6045-3R3Y | Nonstandard | Bourns Inc. | 1
L601, L602 | Semi-shielded Power Inductor | 10 uH | SRN4026-100M | Nonstandard | Bourns Inc. | 2
LD500, LD501, LD502 | LED ORANGE RECT CLEAR 0603 | Orange | LTST-C193KFKT-5A | 0603 | Lite-On Inc. | 3
LD600 | LED CBI 3MM YW/GN/GN TRI LEVEL |  | 551-0003-828F |  | Dialight | 1
OP300 | Optocoupler, Phototransistor Output, Dual Channel, SOIC-8 Package |  | ILD217T | SOIC_8_TALL | Vishay Semiconductors | 1
OSC500 | Oscillator 4 pins 1=OE 2=GND 3=OUT 4=VCC | 60 MHz | CB3LV-5C-60M0000 | 4-Pad SMD | CTS-Frequency Controls | 1
P600, P601 | Surface Mount EMI Shield Frame/Cover |  | SMS-207 | SMD_EMI_SHIELD | Leader Tech Inc. | 2
PT102, PT103, PT200, PT201, PT202, PT203, PT600, PT601, PT602, PT603, PT604, PT605, PT606, PT607, PT608, PT609 | Test Point Wire Termination Pin |  | 3132-0-00-15-00-00-08-0 | TestPoint | Mill-Max Manufacturing Corp. | 16
Q300 | N-Channel Enhancement Mode Vertical DMOS FET |  | ZVN3310F | SOT_23 | Diodes Inc. | 1
Q600 | NPN General Purpose Transistor |  | BC846BMTF | SOT_23 | Fairchild Semiconductor | 1
R200, R201, R226, R227 | Chip Resistor SMD 0603 |  |  | 0603 |  | 4
R202, R203, R214, R215 | Resistor 200R 0.1% 0.1W SMD 0603 | 200 | ERA-3AEB201V | 0603 | Panasonic Electronic Components | 4
R210, R211 | Resistor 0R (Jumper) 2A SMD 0603 | 0 | CRCW06030000Z0EA | 0603 | Vishay Dale | 2
R212, R213 | Resistor 12R 0.1% 0.1W SMD 0805 | 12 | 1-1614884-9 | 0805 | TE Connectivity | 2
R216, R217, R220 | Resistor 1k5 0.1% 0.125W SMD 0805 | 1k5 | ERA-6AEB152V | 0805 | Panasonic Electronic Components | 3
R218 | Resistor 9R1 1% 0.125W SMD 0805 | 9R1 | CRCW08059R10FKEA | 0805 | Vishay Dale | 1
R219 | Resistor 20k 0.5% 0.1W SMD 0603 | 20k | RT0603DRD0720KL | 0603 | Yageo | 1
R221, R222, R223, R224, R225, R228, R506, R507, R603, R605 | Resistor 10k 0.5% 0.1W SMD 0603 | 10k | RT0603DRD0710KL | 0603 | Yageo | 10
R229 | Resistor 47k5 1% 0.1W SMD 0603 | 47k5 | RC1608F4752CS | 0603 | Samsung Electro-Mechanics | 1
R230, R231, R232, R233, R234, R235, R236, R237, R238, R239, R240, R241 | Resistor 620R 1% 0.5W SMD 1206 (Wide) | 620R | LTR18EZPF6200 | 1206W | Rohm Semiconductor | 12
R300 | Resistor 402R 1% 0.1W SMD 0603 | 402 | RC1608F4020CS | 0603 | Samsung Electro-Mechanics | 1
R301 | Resistor 7k5 5% 1W SMD 2512 | 7.5k | RMCF2512JT7K50 | 2512 | Stackpole Electronics Inc. | 1
R302, R500, R501, R502, R503, R504, R505, R622 | Resistor 4k7 1% 0.1W SMD 0603 | 4k7 | RC1608F472CS | 0603 | Samsung Electro-Mechanics | 8
R508 | Resistor 1k 1% 0.1W SMD 0603 | 1k | RC0603FR-071KL | 0603 | Yageo | 1
R509, R510, R511, R600 | Resistor 240R 1% 0.125W SMD 0805 | 240 | RC0805FR-07240RL | 0805 | Yageo | 4
R601, R602 | Resistor 1k3 5% 0.5W SMD 0805 | 1k3 | ERJ-P06J132V | 0805 | Panasonic Electronic Components | 2
R604 | Resistor 75k 0.5% 0.1W SMD 0603 | 75k | RT0603DRD0775KL | 0603 | Yageo | 1
R606, R611 | Resistor 1R 1% 1W SMD 1206 (Wide) | 1 | LTR18EZPFL1R00 | 1206W | Rohm Semiconductor | 2
R607 | Resistor 14k 0.1% 0.1W SMD 0603 | 14k | ERA-3AEB1402V | 0603 | Panasonic Electronic Components | 1
R608, R610 | Resistor 4k42 0.1% 0.1W SMD 0603 | 4k42 | ERA-3AEB4421V | 0603 | Panasonic Electronic Components | 2
R609 | Resistor 47k 0.1% 0.1W SMD 0603 | 47k | ERA-3AEB473V | 0603 | Panasonic Electronic Components | 1
R612 | Resistor 127k 0.1% 0.1W SMD 0603 | 127k | RG1608P-1273-B-T5 | 0603 | Susumu | 1
R613 | Resistor 12k1 0.1% 0.1W SMD 0603 | 12k1 | ERA-3AEB1212V | 0603 | Panasonic Electronic Components | 1
R614 | Resistor 412k 0.1% 0.25W SMD 0805 | 412k | 5-2176094-2 | 0805 | TE Connectivity | 1
R615, R619 | Resistor 2M 0.1% 0.1W SMD 0805 | 2M | 1-1614959-4 | 0805 | TE Connectivity | 2
R616 | Resistor 5k23 0.1% 0.125W SMD 0805 | 5k23 | ERA-6AEB5231V | 0805 | Panasonic Electronic Components | 1
R617, R621 | Resistor 80k6 0.1% 0.125W SMD 0805 | 80k6 | ERA-6AEB8062V | 0805 | Panasonic Electronic Components | 2
R618 | Resistor 576k 0.1% 0.125W SMD 0805 | 576k | ERA-6AEB5763V | 0805 | Panasonic Electronic Components | 1
R620 | Resistor 5k1 0.1% 0.125W SMD 0805 | 5k1 | ERA-6ARB512V | 0805 | Panasonic Electronic Components | 1
Rburden | Ultra High Precision Bulk Metal® Z-Foil Surface Mount Power Resistor in TO-220 | 20R | Y212320R0000A9L | TO220_4 | Vishay Precision Group | 1
RN200 | Quad Matched Resistor Network 1k 15% 0.8W CMRR-Matching 0.015% SMD MSOP-8 | 1k | LT5400BIMS8E-4#TRPBF | MSOP_8 PowerPad | Linear Technology | 1
SW500 | Surface Mount DIP Switch 6 positions |  | 219-6MST |  | CTS Electrocomponents | 1
SW600 | 7914 4 mm SMD & Through-hole Sealed Key Switch |  | 7914S-1-000E |  | Bourns Inc. | 1
TR200 | Vertical Trimpot 1k 10% 0.25W 11 Turns SMD Gull Wing | 1k | PVG5A102C03R00 | J Lead | Murata Electronics North America | 1
U100 | 18-Bit, 670 kSPS, Differential Programmable Input PulSAR ADC |  | AD7634BSTZ | LQFP_48 | Analog Devices | 1
U200 | Precision Gain = 10 Differential Amplifier |  | INA106U | SOIC_8 | Texas Instruments | 1
U201, U202 | Quad, Rail-to-Rail, Fault-Protected, SPST Analog Switches |  | MAX313FESE | SOIC_16 | Maxim Integrated | 2
U203, U204 | 1.1nV/vHz Noise, Low Power, Precision Operational Amplifier |  | OPA211ID | SOIC_8 | Texas Instruments | 2
U205 | LME49724 High Performance, High Fidelity, Fully-Differential Audio Operational Amplifier |  | LME49724MR | SOIC_8 PowerPad | Texas Instruments | 1
U206, U208 | High Precision, Low Noise Operational Amplifiers |  | OPA227U | SOIC_8 | Texas Instruments | 2
U207 | 1ppm/°C, Low-Noise, +5V Voltage Reference |  | MAX6350CSA | SOIC_8 | Maxim Integrated | 1
U209 | High Precision, Low Noise Operational Amplifiers |  | OPA2227UA | SOIC_8 | Texas Instruments | 1
U210 | Precision Centigrade Temperature Sensor |  | LM35DM | SOIC_8 | Texas Instruments | 1
U211 | High-Voltage, High-Current Operational Amplifier |  | OPA547F/500 | DDPAK_7 | Texas Instruments | 1
U300, U301 | LOW POWER SIX-CHANNEL DIGITAL ISOLATOR |  | SI8661BC-B-IS1 | SOIC_16 | Silicon Labs | 2
U302, U303 | 8-BIT BIDIRECTIONAL VOLTAGE-LEVEL TRANSLATOR WITH AUTO-DIRECTION SENSING AND ±15-kV ESD PROTECTION |  | TXB0108PWR | TSSOP_20 | Texas Instruments | 2
U500 | MAX V 1.8V CPLD, 114 IOs, 1270 Logic Elements, 144-Pin TQFP, Commercial Temperature, Speed Grade 4, Pb-Free |  | 5M1270ZT144C4N | TQFP144_A-160 | Altera | 1
U501 | 16 Megabit (2 M x 8-Bit/1 M x 16-Bit) |  | S29AL016J70TFI010 | TSOP_48 | Spansion | 1
U600 | 4.5 V to 17 V Input, 2A/3A Synchronous Step-Down Voltage Regulator |  | TPS563200DDCT | SOT_23_6 | Texas Instruments | 1
U601 | 1.5 A, Low Noise, Fast Transient Response LDO Regulator, 2.1 to 20 V Vin, 1.8 V Vout, 3-pin SOT223 (ST-3), -40 to 125 degC, Pb-Free, Tape and Reel |  | LT1963AEST-1.8#TRPBF | SOT_223 | Linear Technology | 1
U602 | 1.5 A, Low Noise, Fast Transient Response LDO Regulator, 2.1 to 20 V Vin, 3.3 V Vout, 3-pin SOT223 (ST-3), -40 to 125 degC, Pb-Free, Tape and Reel |  | LT1963AEST-3.3#TRPBF | SOT_223 | Linear Technology | 1
U603 | Micropower Low Dropout Regulator with Shutdown, 4.15 to 30 V Vin, 5 V Vout, 3-pin SOT223 (ST-3), 0 to 125 degC, Pb-Free, Tape and Reel |  | LT1129CST-5#TRPBF | SOT_223 | Linear Technology | 1
U604, U605 | 1.1A, Low Noise, Low Dropout Linear Regulator |  | LT1965EMS8E#PBF | MSOP_8 | Linear Technology | 2
U606 | 1.5A, Low Noise, Negative Linear Regulator with Precision Current Limit |  | LT3015EMSE#PBF | MSOP_12 | Linear Technology | 1
U607 | + / - 0.8% Accurate Quad UV / OV Positive / Negative Voltage Supervisor, 125 ns Delay, Industrial, 16-pin SOP (RQ-16), Tube |  | ADM12914-2ARQZ | QSOP_16 | Analog Devices | 1
W200, W201, W203, W600 | Solder Jumper 1-Pole 1-Throw |  |  |  |  | 4
W202 | Solder Jumper 2-Poles 1-Throw |  |  |  |  | 1
 |  |  |  |  | TOTAL | 289
 |  |  |  |  | TOTAL PTH | 22
 |  |  |  |  | TOTAL SMD | 267
