lnls-elp/WEG/Placa de Potência - BOM List.xlsx

Comment | Part Number | Quant | Components | Description | Quantity | Codigo LNLS
Teste Point | TERM QUICKFIT MALE DL .110/.250" codigo 1282 | 1 | PTGND | TERM TEST POINT SLOTTED .118 codigo 1040 marca Keystone Electronics | 1 | AP105311 | http://www.digikey.com/product-search/en?vendor=0&keywords=16F2074
Teste Point |  | 11 | POSITIVO, PT3, PT11, PT14,PT16, PT17, PT18, PT20, +15V, -15V, NEGAT | TERM TEST POINT SLOTTED .118 codigo 1040 marca Keystone Electronics | 11 | AP105310 | http://www.digikey.com/product-search/en?vendor=0&keywords=Keystone+97H6982
Teste Point | TERM TEST POINT SLOTTED .118 codigo 1040 | 8 | POTENCIA, PTG1, PTG2, PTG3,PTG4, PTS1, PTS2, PWM1, PWM2,PWM3, PWM4 | TEST POINT PRINTED CIRCUIT PIN | 8
100nF | CAPC1608X90N | 16 | C11, C13, C16, C18, C22,C24,C25,C26,C28,C38,C40,C44,C47,C48,C50,C35 | CAP CER 0.1UF 50V Y5V 0603 | 16 | AP105289 | http://www.digikey.com/product-detail/en/CC0603ZRY5V9BB104/311-1343-2-ND/2103081
1uF/63V | Capacitor 2824 | 2 | C1, C2, | CAP FILM 1UF 63VDC SMD | 2 | AP105308
10nF | CAPC3225X200N | 4 | CQ1, CQ2, CQ3, CQ4 | CAP FILM 10000PF 100VDC 1210 | 4 | AP105288 | http://www.digikey.com/product-detail/en/ECW-U1103JX5/PCF1360TR-ND/353832
2200uF/50V | CAPACITOR ELETROLITICO 18 | 1 | C5 | CAPACITOR ELETROLITICO DE ALUMINIO 2200UF/35V EM SMD CODIGO UCX1V222MNQ1MS NICHICON | 1 | AP109477
22uF/25V | CAPAE830X620N | 4 | C39, C42, C43, C46 | Solid Tantalum Chip Capacitor, T491 | 4 | AP101716 | http://www.digikey.com/product-detail/en/EEE-1EA220SP/PCE3899TR-ND/766066
470nF/25V | CAPC3216X100N | 2 | C12, C14 | CAP FILM 0.47UF 25VDC SMD 1206 | 2 | AP104045 | http://www.digikey.com/product-detail/en/C3216X7R1H474K160AA/445-1380-2-ND/513965
56u/100V | Capacitor B32526 | 2 | C7, C8 | CAPACITOR DE FILME DE POLIPROPILENO DA SERIE B32526 56UF/63V CODIGO B32526T566K EPCOS (TDK) | 2 | AP109478 | http://www.digikey.com/product-search/en?keywords=%20B32526T566K
6.8uF/25V | CAPMP3528X210N | 6 | C15, C17, C27, C33, C49, C51 | CAP TANT 10UF 25V 20% 1210 | 6 | AP105290 | http://www.digikey.com/pro400duct-detail/en/TR3B685K025C0500/718-1529-2-ND/1859846
6u8F/63V | Capacitor B32523 | 1 | C6 | CAPACITOR DE FILME DE POLIPROPILENO SERIE B32523 6.8UF/100V CODIGO B32523Q1685K EPCOS (TDK) | 1 | AP109479 | http://www.digikey.com/product-detail/en/epcos-tdk/B32523Q1685K/495-4098-ND/2060959
100R | FUSR_BOURNS_MF-R LE4 | 1 | Pt100 | SENSOR DE TEMPERATURA TIPO RTD PT100 +/-0.12 CASE RADIAL CODIGO PPG101B1, US SENSOR | 1 | AP110206 | http://www.digikey.com/product-search/en?keywords=%20PPG101B1
10R | RESC2012X70N | 4 | RG1, RG2, RG3, RG4 | RES 10.0 OHM 1/8W 1% 0805 SMD | 1 | AP101471
27R | RESC2013X84N | 1 | R2 | RES 27.0 OHM 1/8W 1% 0805 SMD | 1 | AP105313 | http://www.digikey.com/product-detail/en/ERJ-6ENF27R0V/P27.0CTR-ND/1746483
2R2 | RESISTOR 4527 2W | 2 | R6, R11 | RES 4.70 OHM 3W 5% SMD 4122 | 2 | AP104041
47R | RESC6331X80N | 4 | RQ1, RQ2, RQ3, RQ4 | RES 47 OHM 1.5W 10% SMD 2512 | 4 | AP105311
1K | RESC1508X63N | 5 | R3, R7, R8, R16,R43 | RES 1K OHM 1/8W 1% 0603 SMD | 1
2K21 | RESC2013X84N | 1 | R34 | RES 2K21 OHM 1/8W 1% 0805 SMD | 1 | AP105317 | http://www.digikey.com/product-detail/en/RC0805FR-072K21L/311-2.21KCRTR-ND/727679
4K7 | RESC1508X63N | 6 | R26, R30, R32, R35, R42, R44 | RES 4K7 OHM 1/8W 1% 0603 SMD | 6 | AP105314
10K | RESC1508X63N | 6 | R24, R28, R31, R33, R41, R46 | RES 10K OHM 1/8W 1% 0603 SMD | 1 | AP105315 | http://www.digikey.com/product-detail/en/MCT06030C1002FP500/MCT0603-10.0K-CFTR-ND/1850440
20K | RESC1508X63N | 3 | R17, R37, R45 | RES 20KOHM 1/8W 1% 0603 SMD | 4 | AP105316 | http://www.digikey.com/product-detail/en/MCT06030C2002FP500/MCT0603-20.0K-CFTR-ND/1850447
100K | RESC1508X63N | 1 | R38 | RES 100K OHM 1/8W 1% 0603 SMD | 4 | AP105318 | http://www.digikey.com/product-detail/en/MCT06030C1003FP500/MCT0603-100K-CFTR-ND/2607822
ADUM1400CRWZ | SOIC16_Wb | 1 | CI15 | DGTL ISO 2.5KV GEN PURP 16SOIC | 4 | AP105314
1N4007 | DIOMELF5025N | 1 | D2 | 1 Amp General Purpose Rectifier | 1 |  | http://www.digikey.com/product-detail/en/diodes-incorporated/DL4007-13-F/DL4007-FDIDKR-ND/1837037
BAS16 | SOT-23 | 4 | DG1, DG2, DG3, DG4 | Silicon Switching Diode for Hi | 2 | AP105316
DFLS1150-7 | SOD-123FL | 6 | D6, D7, DQ1, DQ2, DQ3, DQ4 | DIODE SCHOTKY 100V 250MA SOD12 | 6 | AP105308 | http://www.digikey.com/product-detail/en/DFLS1150-7/DFLS1150DITR-ND/765613
DFLZ15DITR-ND | SOD-123FL | 4 | DGZ1, DGZ2, DGZ3, DGZ4 | DIODO ZENER 15V 1 W EM SMD CASE POWERDI123 CODIGO DFLZ15-7 ,DIODE INC | 4 | AP104042 | http://www.digikey.com/product-detail/en/diodes-incorporated/DFLZ15-7/DFLZ15DITR-ND/726000
BC847 | SOT-23 | 3 | Q5, Q7, Q8 | TRANS NPN GP 100MA 45V SOT23 | 3 | AP105312 | http://www.digikey.com/product-detail/en/BC847B,215/568-1633-2-ND/763237
12A | FUSR_LITTELFUSE_L012 | 1 | F1 | FUSE 12A 24V FAST S MD 1206 | 1 | AP101723 | http://www.digikey.com/product-detail/en/1206SFH120F%2F24-2/1206SFH120F%2F24TR-ND/1993391
2A | FUSR_LITTELFUSE_L012 | 1 | F3 | FUSIVEL 2A 63 VAC RETARDADO EM SMD CASE 1206 CODIGO C1S2 BEL FUSE INC. | 1 | AP101123
220R/100Mhz | 0805 ferrit | 2 | L4, L5 | FERRITE CHIP 220 OHM 0805 | 2 | AP101723
10uH | L1210R | 1 | L3 | INDUTOR DE FILTRO 10UH/900MA SMD CODIGO L1210R100MDWIT KEMET | 1 | AP109508 | http://www.digikey.com/product-search/en?keywords=%20L1210R100MDWIT
G8NW-2 DC_12SK | RELAY G8NW | 1 | RL1 | RELAY AUTOMOTIVE SPDT 30A 12V | 1 | AP105333 | http://www.digikey.com/product-detail/en/G8NW-2H%20DC12%20SK/Z3710-ND/1813575
Header 2 | JUMP | 1 | J1 | Header, 2-Pin | 1
INA105KU | SOIC127P600X175-1 | 1 | CI7 | Precision Unity Gain DiffERENTIAL AMPL | 1 | AP101572 | http://www.digikey.com/product-detail/en/INA105KU/INA105KU-ND/251074
IR2110S | SOIC127P1031X264 | 2 | CI5, CI6 | High and Low Side Drive | 2 |  | http://www.digikey.com/product-detail/en/infineon-technologies-americas-corp/IR2110STRPBF/IR2110SPBFTR-ND/811381
NC7WZ14 | SC70-6 | 1 | CI11 | IC BUFFER DUAL INV SC706 | 1 |  | http://www.digikey.com/product-search/en?keywords=NC7WZ14
NC7WZ16 | SC70-6 | 1 | CI10 | IC BUFFER DUAL NON-INV SC706 | 1 |  | http://www.digikey.com/product-search/en?keywords=NC7WZ16
R1SE-0505-R | R1SE Series | 1 | CI14 | DC/DC CONVERTER 1W 5VIN 5VOUT | 1 |  | http://www.digikey.com/product-search/en?keywords=R1SE-0505-R
R-78E5.0-0.5 | SIP3 | 1 | CI12 | C.I CONVERSOR DC/DC ISOLADO 1W ENTRADA 5V SAIDA +5V 1A CASE 8-SMD R1SE-0505-R RECOM | 1 | AP110124 | http://www.digikey.com/product-search/en?keywords=r1se-0505
S24DE1500 | S24DE15001NDFA | 1 | CI13 | CONVERSOR DC/DC ISOLADO 30W INPUT 9 A 36 OUT +/-15V 1A CODIGOS24DE15001NDFA DELTA ELECTRONICS | 1 | AP109507 | http://www.digikey.com/product-search/en?keywords=S24DE15001NDFA
SI7898DP | VISHAY-POWERPARK 8 DUAL | 2 | Q1, Q2 | 40V DUAL N CHANNEL POWER TRENCH MOSFET | 2 |  | http://www.digikey.com/product-search/en?keywords=SI7898DP
STP30H100DJF | VISHAY_POWERPAK-SINGLE | 1 | D1 | DIODO SCHOTTKY 100V/30A 8-POWERVDFN CODIGO STPS30H100DJF-TRSTMICROELECTRONICS | 1 | AP109480 | http://www.digikey.com/product-search/en?keywords=STPS30H100DJF
TL082D | SOIC127P600X175- | 1 | CI8 | JFET-Input Operational Amplifier | 1 | AP105307 | http://www.digikey.com/product-detail/en/TL082CDR/296-1284-2-ND/276927
AMARELO | LED_DIALIGHT 5502305F | 1 | D8 | LED MODELO CBI ENVOLUCRO EM CAIXA QUADRADA PARA CIRCUITO IMPRESSO COR AMARELO 5 MM CODIGO 550-2305 DIALINGHT | 1 | AP105315 | http://www.digikey.com/product-detail/en/dialight/5502305F/350-1632-ND/809030
VERDE | LED_DIALIGHT 5502205F | 1 | D3 | LED MODELO CBI ENVOLUCRO EM CAIXA QUADRADA PARA CIRCUITO IMPRESSO COR VERDE 5 MM CODIGO 550-2205 DIALINGHT | 1 | AP106715 | http://www.digikey.com/product-detail/en/dialight/5502205F/350-1629-ND/809027
09 05 1486921 | conector din eurd 48 | 1 | P1 | Eurocard DIN 41612, | 1 | AP101471 | http://www.digikey.com/product-detail/en/harting/09051486921/1195-1239-ND/3179822
PAINEL | PAINEL | 1 |  | PAINEL ALUMINIO EUROCARD 3U BRASELLE | 1
 |  |  |  |  | 127
