lnls-elp/WEG/Sub-bastidor FBP - BOM List.xlsx

Fontes de potencia corretora PSB digital
Comment | Description | FORNE | Quantity | Codigo LNLS
Fonte Eletronica 120W +/-15V/4A MGSEL | FONTE DE POTENCIA 35W SAIDA DUPLA SENDO +15V/1.3A/-15V/1.3A DIMENSÕES109 X 82 X 35MM CODIGO TXL 035-1515D | www.tracopower.com | 2 |  | http://br.mouser.com/ProductDetail/TRACO-Power/TXL-035-1515D/
Fonte de Potencia 1500W 15V/100A TDK | FONTE DE POTENCIA 1500W 100A SAIDA 15V CODIGO HWS1500-15 - TDK-LAMBDA | www.tdk-lambda.com | 0 | AP103398 | http://br.mouser.com/ProductDetail/TDK-Lambda/HWS150015/
Transdutor de corrente DccT Lem | TRANSDUTOR DE CORRENTE MODELO LEM ITN 12-P, MONTAGEM PCB MARCA LEM |  | 2 |  | Fornecimento pelo CNPEM
SUB-BASTIDOR | SUB-BASTIDOR CUSTOMIZADO 3U SR700-19”/415 |  | 1
Conector Potencia azul | CONECTOR DE POTENCIA 2 TERMINAIS ELETRICOS 110A, COBERTURA POLICARBONATO COR AZUL,CODIGO SBS50BLU ANDERSON POWER |  | 2 | AP110211
Conector de potencia Preto | CONECTOR DE POTENCIA 2 TERMINAIS ELETRICOS 110A, COBERTURA POLICARBONATO COR PRETO CODIGO SBS50BLK ANDERSON POWER |  | 1 | AP110212
Terminal de Potencia para SBS50 | TERMINAL ELETRICO DE POTENCIA PARA 110A, FIO BITOLA AWG 6, COMPATIVEL COM CONECTORES SBS50 CODIGO 1339G2 ANDERSON POWER |  | 6 | AP110213
Terminal Anel amarelo | terminais anel Hollingsworth modelo FII R5107 |  | 10
Terminal Forquilha Azul | terminais forquilha Hollingsworth modelo BS20583S azul |  | 3
Terminal Forquilha vermelho | terminais forquilhas Hollingsworth modelo BS24043S vermelho |  | 6
TERMINAL SLIP ON VERMELHO | terminais Slip-Ons isolados Hollingsworth SO 5078 vermelho |  | 3
CONECTOR 4 vias Phoenix | 4 Position Terminal Block Plug, Female Sockets 0.150" (3.81mm) 180° Free Hanging (In-Line) |  | 2 |  | http://www.digikey.com/product-search/en?keywords=%201827729
filtro de linha | PWR ENT MOD RCPT IEC320-C14 PNL |  | 1 |  | http://www.digikey.com/product-search/en?keywords=%20DD12.9111.111
PORTA FUSIVEL | FUSE DRWR FOR PWR MOD X-SAFE 1PL |  | 1 |  | http://www.digikey.com/product-search/en?keywords=Schurter%204301.1411
FUSIVEL 5A | FUSE GLASS 5A 250VAC 5X20MM |  | 2 |  | http://www.digikey.com/product-detail/en/schurter-inc/0034.3124/486-1223-ND/639681
Chapa C para SBS-50 | Chapa em C para fixação do SBS-50 em painéis |  | 6
 | FIXADORES DE ABRACADEIRAS COM ADESIVOS CODIGO TMA009A |  | 4 | AG102923
Cinta Hellerman | cintas Hellermann 20 cm. |  | 4
Abracador de Plastico CCL | ABRACADOR DE PLASTICO TIPO P DA SERIE CCL CODIGO CCL001A |  | 2 | AG102924
PARAFUSO CONICO M3 | PARAFUSO MAQUINA, PHILIPS CABECA CONICA (CHATA), ACO NIQUELADO, M3X6MM |  | 20 | AO104271
CONECTOR 8 vias Phoenix | BLOCO DE TERMINAL MACHO 8 POSICOES VERTICAL 3,81MM PTH CODIGO 1803484 PHOENIX CONTACT |  | 4 | AP108368
PLACA DO DccT | PLACA DE CIRCUITO IMPRESSO (DCCT_BOARD_V1.0) |  | 2 | AP102213
Cabo 0.75mm Vermelho | cabo fio 0,75mm - Fio Cabo 0,75 mm 100 metros cor Vermelho |  | 2
Cabo 0.75mm Preto | cabo fio 0,75mm - Fio Cabo 0,75 mm 100 metros cor Preto |  | 2
Cabo 0.75mm azul | cabo fio 0,75mm - Fio Cabo 0,75 mm 100 metros cor azul |  | 2
Cabo 3 x 1,5MM2 | 30 cm CABO 3 X 1,5 MM2, NAS CORES PRETO BRANCO VERDE, ISOLACAO 1KV (https://jbossapps.cnpem.org.br/formularios/inf/item/consulta.jsf) |  | 1
Cabo 4MM2 Vermelho | 70 cm CABO FLEXIVEL 4MM2 VERMELHO (https://jbossapps.cnpem.org.br/formularios/inf/item/consulta.jsf) |  | 1
Cabo 4MM2 Preto | 70 cm CABO FLEXIVEL 4MM2 PRETO (https://jbossapps.cnpem.org.br/formularios/inf/item/consulta.jsf) |  | 1
Cabo 4MM2 BRANCO | 50 cm CABO FLEXIVEL 4MM2 VERMELHO (https://jbossapps.cnpem.org.br/formularios/inf/item/consulta.jsf) |  | 1
Cabo 4MM2 AZUL | 50 cm CABO FLEXIVEL 4MM2 PRETO (https://jbossapps.cnpem.org.br/formularios/inf/item/consulta.jsf) |  | 1
INTEGRAR | INTEGRAR TODOS OS COMPONENTES |  | 1
