lnls-elp/WEG/(list of files, drawings)

Other design files:
DCCT_BOARD_V1.0.PcbDoc
PCB_EXP_RS485_SENC_CON.PcbDoc
