lnls-elp/WEG/(commit log)

2016-08-29 Description document for cooperation between WEG and LNLS
    Acorde de Cooperação - Desenvolvimento de processo paraprodução e testes de eletrônicas para fontes de corrente dos eletroímãs do projeto Sirius
2016-08-29 Technical files for FBP/DRS design
    Technical files used as reference for WEG's technical-commertial proposal.
    [20150205_BOM_PCB_EXP_RS485.xls, 20150205_BOM_PCB_UDC_IHM_V2.0.xls, 20150601_BOM_UDC_PLACA_DE_CONTROLE_V2.0.xlsx, BOM_Mecanica_Exp_RS485_V1.0_20150130_Custo.xlsx, Backplane - BOM List.xls, DCCT_BOARD_V1.0 - BOM List.xls, HRADC_Board_v2_0 - BOM List (WEG).xls, Placa de Potência - BOM List.xlsx]
2016-08-29 Reference Project Files for WEG's First Quotation
    PCBDOC files used by WEG for technical analisys.
    [DCCT_BOARD_V1.0.PcbDoc, PCB_EXP_RS485_SENC_CON.PcbDoc]
